alpaslan44/EE464_Hardware_Project/Snubber_Design_Tool_v1.0.xlsx

Sheet: RC Snubber Design
Biricha RC Snubber Design Tool
Input values in dark yellow cells
Results are shown in light red
Type in the Necessary Parameters
Step 1: Input ringing frequency Fr, (from scope measurement) |  |  | 25000000 | Hz
Step 2: Input total leakage inductance (from measurement)* |  |  | 2.5e-07 | H
Step 3: Input voltage across the snubber, V_snub (from WDS) |  |  | 19.5 | V
Step 4: Input maximum allowable snubber power loss, Ploss_snub |  |  | 0.025 | W
Step 5: Input PSU switching frequency, Fs |  |  | 200000 | Hz
Calculated Component Values
R_snub (ohms) | C_snub (F)
39.3 | 3.28731098e-10
Actual Component Values
Step 6: Type in actual component values used on the board
Actual R_snub (ohms) | Actual C_snub (F) | Ploss_snub (W)
39 | 4.4e-10 | 0.033462
* total leakage as seen on primary must include secondary leakage referred to primary - the east way is just to measure the total leakage with a Bode 100 or similar
* total leakage as seen on secondary must include primary leakage referred to secondary - the east way is just to measure the total leakage with a Bode 100 or similar

Sheet: Transformer Parameter Referral
Biricha Transformer Parameter Referral Tool
 |  |  |  |  | V_pri | Real primary voltage
 |  |  |  |  | V_sec | Real secondary voltage
 |  |  |  |  | V_pri_referred | Primary voltage referred to secondary
 |  |  |  |  | V_sec_referred | Secondary voltage referred to primary
 |  |  |  |  | I_pri | Real primary current
 |  |  |  |  | I_sec | Real secondary current
 |  |  |  |  | I_pri_referred | Primary current referred to secondary
 |  |  |  |  | I_sec_referred | Secondary current referred to primary
 |  |  |  |  | L_L1 | Real primary leakage inductance
 |  |  |  |  | L_L2 | Real secondary leakage inductance
 |  |  |  |  | L_L1_referred | Primary primary leakage inductance referred to secondary
 |  |  |  |  | L_L2_referred | Secondary primary leakage inductance referred to primary
 |  |  |  |  | R_pri | Real primary resistance
 |  |  |  |  | R_sec | Real secondary resistance
 |  |  |  |  | R_pri_referred | Primary resistance referred to secondary
 |  |  |  |  | R_sec_referred | Secondary resistance referred to primary
 |  |  |  |  | N | primary to secondary turn ratio (n:1)
 |  |  |  |  | Lm | Magnetizing Inductance
Referring Parameters from Primary to Secondary
Input N | Input V_sec (V) | V_sec_referred (V) | Input L_L2 (H) | L_L2_referred (H) | Input L_L1 (H) | Total Leakage Inductance as seen on primary (H)
10.00 | 3.00 | 30.00 | 1e-07 | 1e-05 | 1e-05 | 2e-05
 | Input Isec (A) | I_sec_referred (A) | Input R_sec (A) | R_sec_referred (A)
 | 3.00 | 0.30 | 10 | 1000
Referring Parameters from Secondary to Primary
Input N | Input V_pri (V) | V_pri_referred (V) | Input L_L1 (H) | L_L2_referred (H) | Input L_L1 (H) | Total Leakage Inductance as seen on primary (H)
3.00 | 9.00 | 3.00 | 1e-07 | 1.111111111e-08 | 1e-05 | 1.001111111e-05
 | Input Isec (A) | I_sec_referred (A) | Input R_sec (ohms) | R_sec_referred (ohms)
 | 1.00 | 3.00 | 3 | 0.3333333333
