alpaslan44/EE464_Hardware_Project/Compensator Design/Type-III compensator TF.png

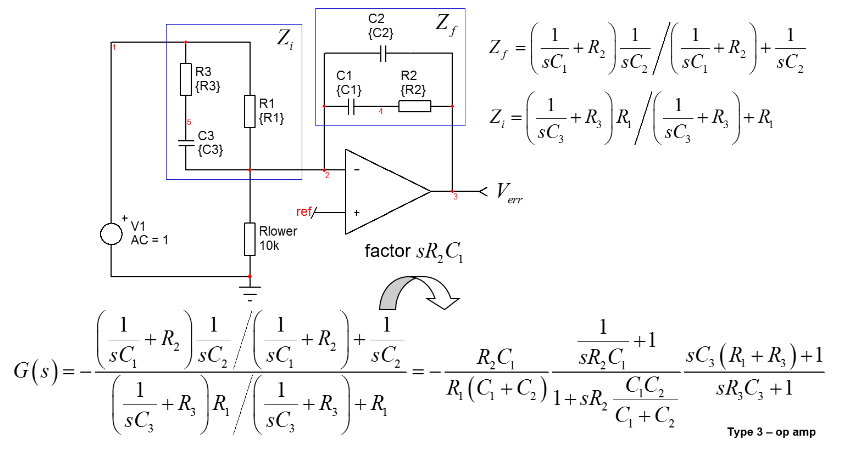
Compensator Design/Type-III compensator TF.png
