alpaslan44/EE464_Hardware_Project/LTSPICE/ltspice_design_step_1.asc

C1: cap; 27µ
C2: cap; 22p
C11: cap; 2.2µ
Cclamp1: cap; 330n
Ccomp: cap; 1n
Ccompz: cap; 470p
Ccsf: cap; 470p
Cct: cap; 3.3n
Cout: cap; 50µ
Cvcc: cap; 120µ
Cvref: cap; 1µ
D1: diode; RF1601NS2D
D2: diode; RF05VAM2S
D3: schottky; MBRS340
D4: zener; UDZV15B
Dbias: schottky; MBR735
Dclamp1: schottky; RB218NS150
L1: ind2; 15µ
L2: ind2; 15µ
L3: ind2; 15µ
Lleakage: ind2; 1.72µ
M1: nmos; Si4488DY
Q1: npn; 2N2222
Q2: npn; 2N2222
R2: res; 15.4k
R3: res; 1.1k
Rbias: res; 1k
Rbleeder: res; 10k
Rclamp1: res; 2k
Rcomp: res; 10k
Rcompz: res; 205k
Rcsf: res; 1k
Rf: res; 0.5k
Rfbb: res; 2.74k
Rfbg: res; 5k
Rfbu: res; 13.7k
Rg: res; 10
RLED: res; 4.7k
Rout: res; 5
Rramp: res; 3.4k
Rrt: res; 5.6k
Rsense: res; 0.1
Rstart: res; 3k
Rvcc: res; 10
U1: LT1242
U2: PC817A
U3: LT1009
V1: voltage; 24
Named nets: 0, Voutput, Sec_Diode
K1 L1 L2 L3 1
.tran 0.5m
